ra0sms/Hardware_scheduler/(list of files, drawings)

Other design files:
DipTrace/cron_pcb.dip
DipTrace/cron_pcb_route.dip
DipTrace/gps_cron_sch.dch
DipTrace/gps_cron_sch_v2.dch
