ra0sms/Hardware_scheduler/code/Core/Src/main.c

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
/* Includes ------------------------------------------------------------------*/
#include "main.h"

/* USER CODE BEGIN Includes */
#include "nmea.h"
/* USER CODE END Includes */


/* USER CODE BEGIN PV */
nmea_t gps;
uint8_t minute = 0;
uint8_t hour = 0;
uint8_t sec = 0;
uint8_t month = 0;
uint8_t day = 0;
uint8_t year = 0;
uint8_t temp = 0;
uint32_t hexPage;
float latitude = 0;
float longitude = 0;
float altitude = 0;
char out[100];

/*TIMETABLE FOR ALL BANDS*/
int time80[] = {2,22,42};
int time40[] = {6,26,46};
int time30[] = {8,28,48};
int time20[] = {10,30,50};
int time17[] = {12,32,52};
int time15[] = {14,34,54};
int time12[] = {16,36,56};
int time10[] = {18,38,58};
int timeOff1[] = {0,20,40};
int timeOff2[] = {4,24,44};

/* USER CODE END PV */

void SystemClock_Config(void);
static void MX_GPIO_Init(void);
static void MX_TIM17_Init(void);
static void MX_USART1_UART_Init(void);
static void MX_USART2_UART_Init(void);
/* USER CODE BEGIN PFP */
void USART1_Send (char chr){
	while (!(USART1->ISR & USART_ISR_TC));
	USART1->TDR = chr;
}

void USART1_Send_String (char* str){
	uint8_t i = 0;
	while(str[i])
	USART1_Send (str[i++]);
}

void USART1_Send_IntToString (uint16_t data){
	char buffer[sizeof(uint16_t) * 8 + 1];
	utoa(data, buffer, 10);
	USART1_Send_String(buffer);
	USART1_Send_String(" \r\n");
}

void SendGpsDataToUsart1() {
	if (nmea_available(&gps)) {
		nmea_gnss_time_h(&gps, &hour);
		nmea_gnss_time_m(&gps, &minute);
		nmea_gnss_time_s(&gps, &sec);
		nmea_gnss_date_d(&gps, &day);
		nmea_gnss_date_m(&gps, &month);
		nmea_gnss_date_y(&gps, &year);
		nmea_gnss_latitude_deg(&gps, &latitude);
		nmea_gnss_longitude_deg(&gps, &longitude);
		nmea_gnss_altitude_m(&gps, &altitude);
		sprintf(out, "Time: %d:%d:%d\r\n Position: %3.2f %3.2f\r\n Date: %d.%d.%d\r\n", hour,
				minute, sec, latitude, longitude, day, month, year);
		USART1_Send_String(out);
		nmea_available_reset(&gps);
	}
}

void SetBootEnable() {
	FLASH->KEYR = (uint32_t) 0x45670123;
	FLASH->KEYR = (uint32_t) 0xCDEF89AB;
	LL_mDelay(1);
	FLASH->OPTKEYR = (uint32_t) 0x08192A3B;
	FLASH->OPTKEYR = (uint32_t) 0x4C5D6E7F;
	LL_mDelay(1);
	FLASH->CR &= ~FLASH_CR_OPTLOCK;
	FLASH->OPTR |= FLASH_OPTR_nBOOT1;
	FLASH->OPTR &= ~FLASH_OPTR_nBOOT_SEL;
	LL_mDelay(1);
	FLASH->CR |= FLASH_CR_OPTSTRT;
	LL_mDelay(1);
	FLASH->CR |= FLASH_CR_OBL_LAUNCH;
	LL_mDelay(1);
	FLASH->CR |= FLASH_CR_LOCK;
}

uint32_t getHexAddressPage(int dataPage){
	uint32_t bits       = PAGE_SECTOR * dataPage;
	uint32_t hexAddress = FLASH_INIT + bits;
	return hexAddress;
}


void memoryPageErase(uint32_t memoryPage){
	HAL_StatusTypeDef eraseHandler = HAL_FLASH_Unlock();

	eraseHandler = FLASH_WaitForLastOperation(500);
	__HAL_FLASH_CLEAR_FLAG(FLASH_FLAG_EOP | FLASH_FLAG_WRPERR | FLASH_FLAG_PGAERR);
	FLASH_PageErase(FLASH_BANK_1, memoryPage);

	eraseHandler = FLASH_WaitForLastOperation(500);
	CLEAR_BIT(FLASH->CR, FLASH_CR_PER);
	HAL_FLASH_Lock();
}

void WriteToEEPROM (uint32_t hexPage, int dataA){
	memoryPageErase(DATA_PAGE);
	HAL_FLASH_Unlock();
	HAL_FLASH_Program(TYPEPROGRAM_DOUBLEWORD, hexPage, dataA);
	HAL_FLASH_Lock();
}

uint32_t ReadFromEEPROM (uint32_t hexAddress){
	return *(uint32_t*)hexAddress;
}

void ResetAllOutputs() {
	LL_GPIO_ResetOutputPin(K1_GPIO_Port, K1_Pin);
	LL_GPIO_ResetOutputPin(K2_GPIO_Port, K2_Pin);
	LL_GPIO_ResetOutputPin(K3_GPIO_Port, K3_Pin);
	LL_GPIO_ResetOutputPin(K4_GPIO_Port, K4_Pin);
	LL_GPIO_ResetOutputPin(K5_GPIO_Port, K5_Pin);
	LL_GPIO_ResetOutputPin(K6_GPIO_Port, K6_Pin);
	LL_GPIO_ResetOutputPin(K7_GPIO_Port, K7_Pin);
	LL_GPIO_ResetOutputPin(K8_GPIO_Port, K8_Pin);
	LL_GPIO_ResetOutputPin(A1_GPIO_Port, A1_Pin);
	LL_GPIO_ResetOutputPin(A2_GPIO_Port, A2_Pin);
	LL_GPIO_ResetOutputPin(A3_GPIO_Port, A3_Pin);
	LL_GPIO_ResetOutputPin(A4_GPIO_Port, A4_Pin);
	LL_GPIO_ResetOutputPin(A5_GPIO_Port, A5_Pin);
	LL_GPIO_ResetOutputPin(A6_GPIO_Port, A6_Pin);
	LL_GPIO_ResetOutputPin(A7_GPIO_Port, A7_Pin);
	LL_GPIO_ResetOutputPin(A8_GPIO_Port, A8_Pin);
}

int IsTime80(){
	if ((minute == (time80[0]-1) || minute == (time80[1]-1) || minute == (time80[2]-1)) && (sec == 59)) return 1;
	if (minute>=time80[0] && minute<timeOff2[0]) return 1;
	if (minute>=time80[1] && minute<timeOff2[1]) return 1;
	if (minute>=time80[2] && minute<timeOff2[2]) return 1;
	return 0;
}

int IsTime40(){
	if ((minute == (time40[0]-1) || minute == (time40[1]-1) || minute == (time40[2]-1)) && (sec == 59)) return 1;
	if (minute>=time40[0] && minute<time30[0]) return 1;
	if (minute>=time40[1] && minute<time30[1]) return 1;
	if (minute>=time40[2] && minute<time30[2]) return 1;
	return 0;
}

int IsTime30(){
	if ((minute == (time30[0]-1) || minute == (time30[1]-1) || minute == (time30[2]-1)) && (sec == 59)) return 1;
	if (minute>=time30[0] && minute<time20[0]) return 1;
	if (minute>=time30[1] && minute<time20[1]) return 1;
	if (minute>=time30[2] && minute<time20[2]) return 1;
	return 0;
}

int IsTime20(){
	if ((minute == (time20[0]-1) || minute == (time20[1]-1)  || minute == (time20[2]-1) ) && (sec == 59)) return 1;
	if (minute>=time20[0] && minute<time17[0]) return 1;
	if (minute>=time20[1] && minute<time17[1]) return 1;
	if (minute>=time20[2] && minute<time17[2]) return 1;
	return 0;
}

int IsTime17(){
	if ((minute == (time17[0]-1) || minute == (time17[1]-1) || minute == (time17[2]-1)) && (sec == 59)) return 1;
	if (minute>=time17[0] && minute<time15[0]) return 1;
	if (minute>=time17[1] && minute<time15[1]) return 1;
	if (minute>=time17[2] && minute<time15[2]) return 1;
	return 0;
}

int IsTime15(){
	if ((minute == (time15[0]-1) || minute == (time15[1]-1) || minute == (time15[2]-1)) && (sec == 59)) return 1;
	if (minute>=time15[0] && minute<time12[0]) return 1;
	if (minute>=time15[1] && minute<time12[1]) return 1;
	if (minute>=time15[2] && minute<time12[2]) return 1;
	return 0;
}

int IsTime12(){
	if ((minute == (time12[0]-1) || minute == (time12[1]-1) || minute == (time12[2]-1)) && (sec == 59)) return 1;
	if (minute>=time12[0] && minute<time10[0]) return 1;
	if (minute>=time12[1] && minute<time10[1]) return 1;
	if (minute>=time12[2] && minute<time10[2]) return 1;
	return 0;
}

int IsTime10(){
	if ((minute == (time10[0]-1) || minute == (time10[1]-1) || minute == (time10[2]-1) ) && (sec == 59)) return 1;
	if (minute>=time10[0] && minute<timeOff1[0]) return 1;
	if (minute>=time10[1] && minute<timeOff1[1]) return 1;
	if (minute>=time10[2] && minute<timeOff1[2]) return 1;
	if (minute<2) return 1;
	return 0;
}

int IsTimeOff() {
	if ((minute == (timeOff1[0] - 1) || minute == (timeOff1[1] - 1)
			|| minute == (timeOff1[2] - 1)) && (sec == 59))
		return 1;
	if (minute >= timeOff1[0] && minute < time80[0])
		return 1;
	if (minute >= timeOff1[1] && minute < time80[1])
		return 1;
	if (minute >= timeOff1[2] && minute < time80[2])
		return 1;
	if (minute < 2)
		return 1;

	if ((minute == (timeOff2[0] - 1) || minute == (timeOff2[1] - 1)
			|| minute == (timeOff2[2] - 1)) && (sec == 59))
		return 1;
	if (minute >= timeOff2[0] && minute < time40[0])
		return 1;
	if (minute >= timeOff2[1] && minute < time40[1])
		return 1;
	if (minute >= timeOff2[2] && minute < time40[2])
		return 1;
	if (minute < 2)
		return 1;
	return 0;
}


void WSPR_Schedule() {
	if (IsTime80()) {
		ResetAllOutputs();
		LL_GPIO_SetOutputPin(K1_GPIO_Port, K1_Pin);
		LL_GPIO_SetOutputPin(A1_GPIO_Port, A1_Pin);
	}
	if (IsTime40()) {
		ResetAllOutputs();
		LL_GPIO_SetOutputPin(K2_GPIO_Port, K2_Pin);
		LL_GPIO_SetOutputPin(A2_GPIO_Port, A2_Pin);
	}
	if (IsTime30()) {
		ResetAllOutputs();
		LL_GPIO_SetOutputPin(K3_GPIO_Port, K3_Pin);
		LL_GPIO_SetOutputPin(A3_GPIO_Port, A3_Pin);
	}
	if (IsTime20()) {
		ResetAllOutputs();
		LL_GPIO_SetOutputPin(K4_GPIO_Port, K4_Pin);
		LL_GPIO_SetOutputPin(A4_GPIO_Port, A4_Pin);
	}
	if (IsTime17()) {
		ResetAllOutputs();
		LL_GPIO_SetOutputPin(K5_GPIO_Port, K5_Pin);
		LL_GPIO_SetOutputPin(A5_GPIO_Port, A5_Pin);
	}
	if (IsTime15()) {
		ResetAllOutputs();
		LL_GPIO_SetOutputPin(K6_GPIO_Port, K6_Pin);
		LL_GPIO_SetOutputPin(A6_GPIO_Port, A6_Pin);
	}
	if (IsTime12()) {
		ResetAllOutputs();
		LL_GPIO_SetOutputPin(K7_GPIO_Port, K7_Pin);
		LL_GPIO_SetOutputPin(A7_GPIO_Port, A7_Pin);
	}
	if (IsTime10()) {
		ResetAllOutputs();
		LL_GPIO_SetOutputPin(K8_GPIO_Port, K8_Pin);
		LL_GPIO_SetOutputPin(A8_GPIO_Port, A8_Pin);
	}
	if (IsTimeOff()) {
		ResetAllOutputs();
	}

}

/* USER CODE END PFP */

/**
  * @brief  The application entry point.
  * @retval int
  */
int main(void)
{
  /* MCU Configuration--------------------------------------------------------*/

  /* Reset of all peripherals, Initializes the Flash interface and the Systick. */
  HAL_Init();

  /* Configure the system clock */
  SystemClock_Config();

  /* Initialize all configured peripherals */
  MX_GPIO_Init();
  MX_TIM17_Init();
  MX_USART1_UART_Init();
  MX_USART2_UART_Init();
  /* USER CODE BEGIN 2 */
  nmea_init(&gps, USART2, 1024);
  LL_TIM_EnableCounter(TIM17);
  LL_TIM_EnableIT_UPDATE(TIM17);
  hexPage = getHexAddressPage(DATA_PAGE);
  WriteToEEPROM(hexPage, 123);
  temp = ReadFromEEPROM(hexPage);
  //SetBootEnable();
  /* USER CODE END 2 */

  /* Infinite loop */
  /* USER CODE BEGIN WHILE */
	while (1) {
		nmea_loop(&gps);
		SendGpsDataToUsart1();
		WSPR_Schedule();
		LL_mDelay(300);

		/* USER CODE END WHILE */

		/* USER CODE BEGIN 3 */
	}
  /* USER CODE END 3 */
}

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
