ra0sms/Hardware_scheduler/code/Core/Inc/main.h

#define FLASH_INIT  0x08000000   //This is the page zero of our flash
#define DATA_SPACE  8            //Samples between each saved element
#define PAGE_SECTOR 2048         //Page size
#define DATA_PAGE   31           //Page that will store our data
#define A1_Pin LL_GPIO_PIN_0
#define A1_GPIO_Port GPIOA
#define A2_Pin LL_GPIO_PIN_1
#define A2_GPIO_Port GPIOA
#define A3_Pin LL_GPIO_PIN_4
#define A3_GPIO_Port GPIOA
#define A4_Pin LL_GPIO_PIN_5
#define A4_GPIO_Port GPIOA
#define A5_Pin LL_GPIO_PIN_6
#define A5_GPIO_Port GPIOA
#define A6_Pin LL_GPIO_PIN_7
#define A6_GPIO_Port GPIOA
#define K1_Pin LL_GPIO_PIN_0
#define K1_GPIO_Port GPIOB
#define K2_Pin LL_GPIO_PIN_1
#define K2_GPIO_Port GPIOB
#define K3_Pin LL_GPIO_PIN_2
#define K3_GPIO_Port GPIOB
#define A7_Pin LL_GPIO_PIN_8
#define A7_GPIO_Port GPIOA
#define LED_Pin LL_GPIO_PIN_6
#define LED_GPIO_Port GPIOC
#define A8_Pin LL_GPIO_PIN_15
#define A8_GPIO_Port GPIOA
#define K4_Pin LL_GPIO_PIN_3
#define K4_GPIO_Port GPIOB
#define K5_Pin LL_GPIO_PIN_4
#define K5_GPIO_Port GPIOB
#define K6_Pin LL_GPIO_PIN_5
#define K6_GPIO_Port GPIOB
#define K7_Pin LL_GPIO_PIN_6
#define K7_GPIO_Port GPIOB
#define K8_Pin LL_GPIO_PIN_7
#define K8_GPIO_Port GPIOB
